GregoryOrd/GregWatch/pcbDesign/GregWatchPcb/GregWatchPcb.kicad_pcb

## KiCad design pcbDesign/GregWatchPcb/GregWatchPcb.kicad_pcb (2021-06-20)

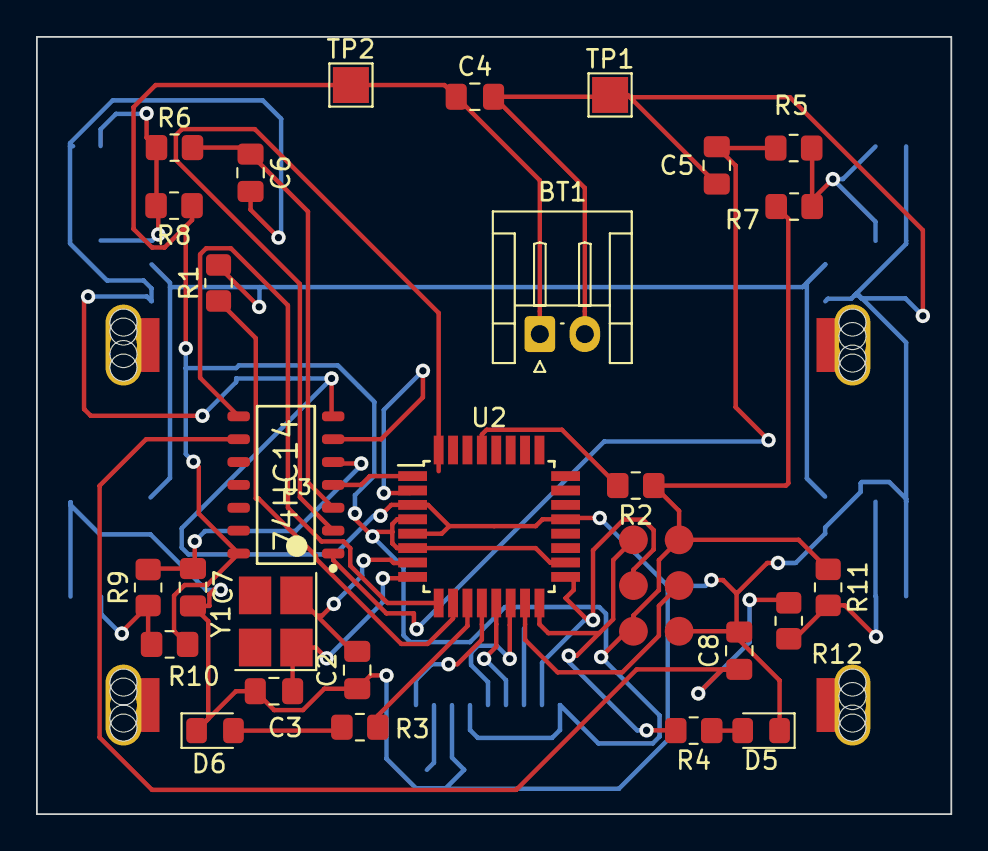
[picture p1: board GregWatchPcb.kicad_pcb from above]

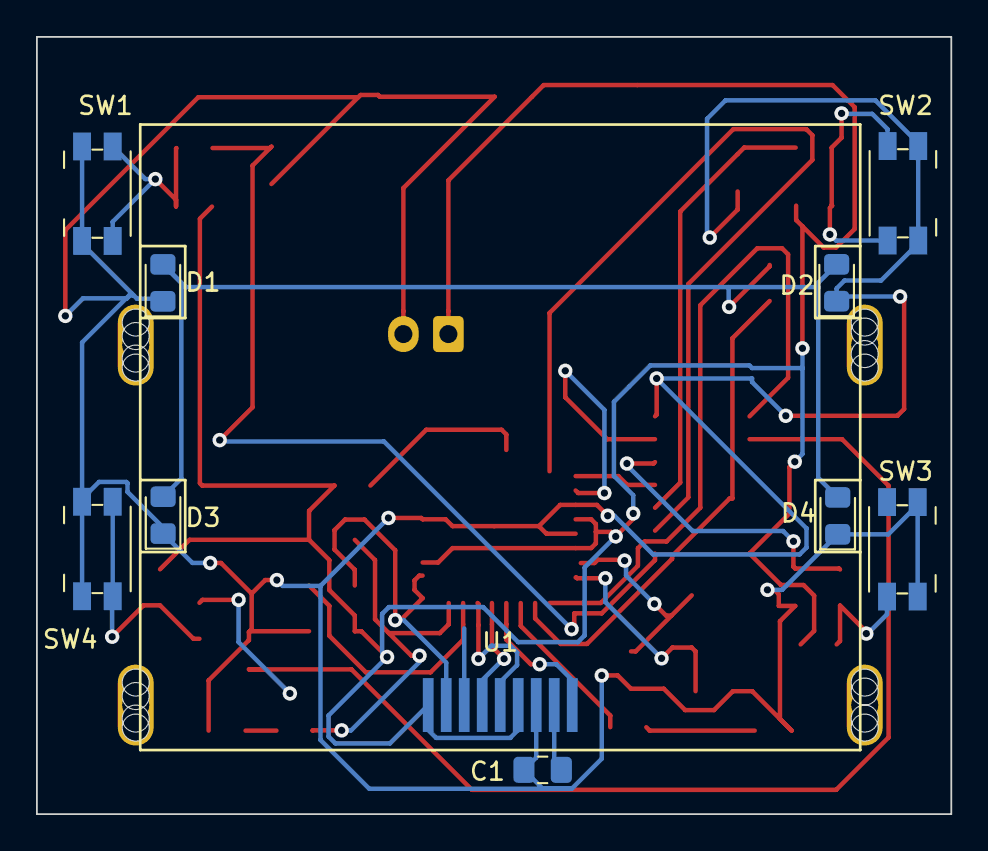
[picture p2: board GregWatchPcb.kicad_pcb from below]

Board: 2 copper layers, 50.8 x 43.2 mm, 38 parts (10 on the bottom side), 29 nets.

Parts:
BT1: Battery_Cell; JST_EH_S2B-EH_1x02_P2.50mm_Horizontal
C1, C5, C6, C7, C8: 0.1u; C_0805_2012Metric_Pad1.18x1.45mm_HandSolder
C2, C3: 22p; C_0805_2012Metric_Pad1.18x1.45mm_HandSolder
C4: 10u; C_0805_2012Metric_Pad1.18x1.45mm_HandSolder
D1, D2, D3, D4, D5, D6: LED; LED_0805_2012Metric_Pad1.15x1.40mm_HandSolder
J1: AVR-ISP-6
R1, R3, R4: 100; R_0805_2012Metric_Pad1.20x1.40mm_HandSolder
R2, R5, R6, R7, R8, R9, R10, R11, R12: 10k; R_0805_2012Metric_Pad1.20x1.40mm_HandSolder
SW1, SW2, SW3, SW4: SW_Push; Panasonic_EVQPUJ_EVQPUA
TP1, TP2: TestPoint; TestPoint_Pad_2.0x2.0mm
U1: Nokia_5110_LCD; Nokia_5110-3310_LCD-F.Paste-B.Paste
U2: ATmega328P-AU; TQFP-32_7x7mm_P0.8mm
U3: 74HC14; Texas_Instruments-CD74HC14-Level_C
Y1: 16M; Crystal_SMD_3225-4Pin_3.2x2.5mm_HandSoldering

Connections:
unnamed: BT1.1, C4.1, J1.2, J1.5, R2.1, R7.1, R8.1, R10.1, R11.1, TP2.1, U1.4, U1.9, U2.4, U2.6, U2.18, U3.14
unnamed: BT1.2, C1.1, C2.1, C3.1, C4.2, C5.2, C6.2, C7.2, C8.2, D1.1, D2.1, D3.1, D4.1, D5.1, D6.1, J1.6, SW1.1, SW2.1, SW3.1, SW4.1, TP1.1, U1.3, U2.3, U2.5, U2.21, U3.7
unnamed: C1.2, U1.2
unnamed: C2.2, U2.7, Y1.2
unnamed: C3.2, U2.8, Y1.1
unnamed: C5.1, R5.2, U3.1
unnamed: C6.1, R6.2, U3.3
unnamed: C7.1, R9.2, U3.5
unnamed: C8.1, R12.2, U3.9
unnamed: D1.2, D2.2, D3.2, D4.2, R1.2
unnamed: D5.2, R4.1
unnamed: D6.2, R3.1
unnamed: J1.1, R4.2, U2.16
unnamed: J1.3, U1.8, U2.17
unnamed: J1.4, U1.7, U2.15
unnamed: R1.1, U2.10
unnamed: R2.2, U2.29
unnamed: R3.2, U2.11
unnamed: R5.1, R7.2, SW1.2
unnamed: R6.1, R8.2, SW2.2
unnamed: R9.1, R10.2, SW3.2
unnamed: R11.2, R12.1, SW4.2
unnamed: U1.1, U2.12
unnamed: U1.5, U2.14
unnamed: U1.6, U2.13
unnamed: U2.1, U3.4
unnamed: U2.2, U3.6
unnamed: U2.9, U3.8
unnamed: U2.32, U3.2
