GregoryOrd/GregWatch/src/stopWatch/deviceDrivers/display/communicationProtocol/spi.c

#include "spi.h"

void initSpiInterface()
{
   SPI_DDR = (1 << MOSI) | (1 << SCK) | (1 << SS) | (1 << RST) | (1 << DC);
   SPCR = (1 << SPE) | (1 << MSTR) | (1 << SPR0);
}

void enableSlave() { SPI_PORT &= ~(1 << SS); }

void disableSlave() { SPI_PORT |= (1 << SS); }

void setResetPinLow() { SPI_PORT &= ~(1 << RST); }

void setResetPinHigh() { SPI_PORT |= (1 << RST); }

void resetSlave()
{
   setResetPinLow();
   _delay_ms(100);
   setResetPinHigh();
}

void transmitCommand(unsigned char data)
{
   SPI_PORT &= ~(1 << DC);
   transmitByte(data);
}

void transmitData(unsigned char data)
{
   SPI_PORT |= (1 << DC);
   transmitByte(data);
}

void transmitByte(unsigned char byte)
{
   SPDR = byte;
   waitForEndOfTransmissionFlagToGoHigh();
}

void waitForEndOfTransmissionFlagToGoHigh()
{
#ifndef TEST
   while (!(SPSR & (1 << SPIF)))
   {
   };
#endif
}
