GregoryOrd/GregWatch/(commit log)

2021-04-19 Now showing a timer at 00:00 and switching to 00:01 after one second
2021-04-28 Improved bit pattern for 7 to have a diagonal leg.
2021-04-29 First failing test after GregBuild update. hardwareSim.so and timeSim.so now found under the repo/s lib directory.
    [TestSPI.c, hardwareSim.h, spi.h]
2021-04-30 Test cases for all functions in spi.h. Some commented out while waiting for updates to GregTest
2021-04-30 Back out of the SPI directory
2021-05-01 Move around spi.h includes
2021-05-07 Switching to a timer interrupt instead of _delay_ms for the stop watch.
2021-05-08 Add #define IDR to the hardwareSim to get rid of error when compiling for tests.
    [hardwareSim.h]
2021-05-08 Move time related files to timer directory
2021-05-09 First version of the stop and start button.
2021-06-04 Created fuses.txt to record what configuration is being used for the fuse bits on the AtMega328p microcontroller.
2021-06-06 Using INT0 for the pause button.
2021-06-10 Starting to put together a schematic using KiCad
    [GregWatchPcb.kicad_pcb, GregWatchPcb.sch]
2021-06-11 Move SPI lines for screen to the right
    [GregWatchPcb.sch]
2021-06-11 Using nokia 5110 schematic symbol
    [GregWatchPcb.sch]
2021-06-11 Add backlight LEDs and button circuits
    [GregWatchPcb.sch]
2021-06-11 Added resistance and capacitance values to all resistors and capacitors
    [GregWatchPcb.sch]
2021-06-11 Annotated schematic and corrected some RC values
    [GregWatchPcb.sch]
2021-06-13 Added footprints to the schematic components
    [GregWatchPcb.sch]
2021-06-13 Exported schematic as netlist and imported it into Pcbnew
2021-06-15 Screen and backlight LED components arranged on the back of the PCB
    [GregWatchPcb.sch]
2021-06-15 Move LEDs and flip capacitor and resistor to make sure things fit under the clip on screen
    [GregWatchPcb.kicad_pcb]
2021-06-15 Moved switched and ISP pad in place. Only partial connections so far.
    [GregWatchPcb.kicad_pcb]
2021-06-16 Switch interrupt to rising edge for on-press behaviour instead of on-release behaviour
2021-06-16 First button connected
    [GregWatchPcb.kicad_pcb]
2021-06-16 Top two buttons connected
    [GregWatchPcb.kicad_pcb]
2021-06-16 Connected the ICSP programmer pad
    [GregWatchPcb.kicad_pcb]
2021-06-17 Connected the third button
    [GregWatchPcb.kicad_pcb]
2021-06-17 Place and routed the power and IC components
    [GregWatchPcb.kicad_pcb, GregWatchPcb.sch]
2021-06-17 Placed all components. No traces yet.
    [GregWatchPcb.kicad_pcb, GregWatchPcb.sch]
2021-06-17 Added connection for all components on the board
    [GregWatchPcb.kicad_pcb, GregWatchPcb.sch]
2021-06-20 Add battery to schematic and JST connector for the battery to the PCB
    [GregWatchPcb.kicad_pcb, GregWatchPcb.sch]
2021-06-20 Moved some of the component labels
    [GregWatchPcb.kicad_pcb]
2021-08-01 Update fuses.txt to specify fuses for internal vs external oscillator
2021-12-12 Now using light sensor to toggle backlight
2021-12-12 Add wiring note to lightSensor.h until PCB schematics can be updated
2021-12-12 Change buttons to use pin change rather than external interrupts.
    The light sensor temporarily disabled during this change.
    Using pin change rather than external interrupts so that we can
    have four buttons; there are only two external interrupts.
    Will change the light sensor to a different pin so that we can have all
    of the buttons come into pins beside each other.
2021-12-12 Use for loop instead of nested ifs to search through the buttons
2021-12-12 Change backlight pin and re-enable the lightsensor.
2021-12-12 Create deviceDrivers folder
2021-12-12 Move global interrupt enabling to main init function instead of timer init
2021-12-12 Change to timer1 to reduce clock drift.
    Also move timeState and timeDefs into timer.
    [buttons.c]
2022-09-28 Using host name for raspberry pi
